sandro2/xmega-qrp/Documentation/Final_Report/Final_Report.pdf

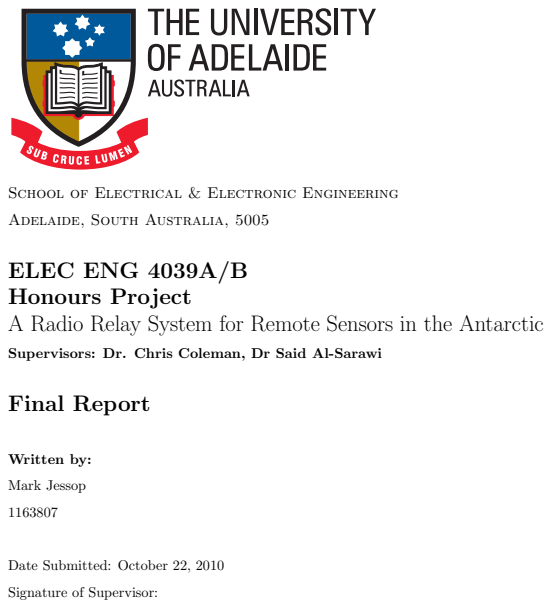
[picture p5: page 1]
Final Report; Written by:; Mark Jessop

School of Electrical & Electronic Engineering

Adelaide, South Australia, 5005

ELEC ENG 4039A/B
Honours Project
A Radio Relay System for Remote Sensors in the Antarctic

Supervisors: Dr. Chris Coleman, Dr Said Al-Sarawi

Date Submitted: October 22, 2010

Signature of Supervisor:

Abstract

A common problem with remote sensor systems is the retrieval of data. Satellite-based sys-

tems are expensive, as is travelling to the sensor. HF propagation provides an inexpensive

alternative. Radio signals below 30MHz can easily bounce off the ionosphere, travelling

thousands of kilometres using only a few watts of transmit power. Based around an At-

mel XMega Micro-Controller and using Direct Digital Synthesis techniques, this project

aims to provide a reliable low power HF telemetry system, usable in a variety of remote

telemetry applications. By making use of the XMega’s power-save modes and using high-

efficiency RF amplifiers, power consumption is minimised, allowing months of operation

from battery power.

CONTENTS | CONTENTS

# Contents

1 Introduction | 4
2 Hardware | 6
3 Software | 8
4 Testing | 8
5 Project Management | 8
6 References | 8
Appendix A XMega Dry Ice Testing | 9
Appendix B Software | 10
Appendix C Schematics & PCBs | 11

1 INTRODUCTION

# 1 Introduction

Many scientific experiments require data logging over a long time period, and in remote locations. To

further research progress, it is desirable for some of the collected data to be accessible throughout the

run of the experiment.

A number of solutions exist to obtain data from a remote sensor unit. The first is to physically access

the remote sensor station, and copy data from whatever storage may exist. For very remote sensor

units visiting the site may be impractical or too costly, so some form of wireless communication is

often used.

Satellite data transmission is a reliable way of retrieving data, but comes at a high cost. For example,

using the Iridium Satellite constellation to transmit data would cost approximately USD$2.50 per

minute, with a 2400 baud data rate[1]

The other option is to other methods of radio communication. For reasonably short (<50km) distances

VHF or UHF telemetry can be used. For example, the Australian Bureau of Meteorology uses a

network of VHF transmitters[2] and repeaters to obtain data from weather stations around Adelaide.

VHF and UHF can work for longer distances (>50km), but with less reliability. Transmission at these

distances relies on tropospheric ducting, a phenomenon that is not always present. To obtain high

reliability long distance transmission, we must move further down the electromagnetic spectrum, to

the HF (‘high frequency’) band.

### The Ionosphere

Radio waves in the HF band propagate mainly by two means: ground-wave and sky-wave. Ground-

wave, as the name suggests, travel along the surface of the earth. Ground-wave signals are attenuated

as they travel along the earth’s surface, limiting their distance. Sky-waves however, refract off a charged

region of the earth’s atmosphere called the ionosphere, and can travel extremely long distances.

The ionosphere is a complex and ever-changing layer (actually multiple layers) of ionized particles

that surrounds our planet. It consists of multiple layers , given the letters D, E and F. The D-layer,

which is the lowest and is strongest during the day, attenuates (absorbs) RF energy below a certain

frequency. The E and F layers, however, reflect RF energy below a certain critical frequency, fc.

This property enables HF radio signals to be ‘bounced’ off the ionosphere, even multiple times, to

communicate over long distances. Losses from the D-layer, and the critical frequencies of the E and F

layers determine the Lowest Usable Frequency (LUF) and Maximum Usable Frequency (MUF) for long

distance communication. Ionospheric prediction services, such as the one provided by the Australian

government[3]
, provide tools to predict these frequencies, and hence determine the optimal frequency

1 INTRODUCTION

for reliable communication.

Another consideration is the angle at which a radio wave interacts with the ionosphere. If a radio signal

is aimed at the horizon it will hit the ionosphere at a shallow angle, resulting in very long propagation

distances, possibly thousands of kilometres. For shorter distances the signal is aimed close to vertical,

allowing much shorter hops, perhaps a few hundred kilometres. This method of transmission is called

‘Near Vertical-Incidence Skywave’ (NVIS) and is the primary method this project will use to transmit

data.

### Project Applications & Aim

Design and build a low power short wave data transmitter that can translate low rate data

into a modulated short wave output with sufficient power to transmit the data over several

hundred kilometres on an Antarctic communication path. - Original Project Aim

This project was originally intended to be used by a researcher stationed in Antarctica, hence the

project name. Throughout the course of the project, lack of information from the researcher prompted

a widening of the project’s scope to include other telemetry applications. Examples include:

- Use in the Australian outback for energy research.
- Use on remote islands, for weather monitoring.
- As a telemetry system for a high-altitude weather balloon.

At it’s core, the purpose of transmitter is to read in data from a number of sources, buffer the data,

and then transmit it using some form of HF radio modulation. The exact form of HF modulation was

not defined, to allow experimentation with a number of different modes. To enable high power testing

without many licensing issues, it was decided that the project would target the 80m (3.5MHz) and

40m (7MHz) amateur radio bands. This also had the added benefit of having a large number of radio

operators available to report on signal reception.

To keep the spirit of the original application it was decided to keep the constraints which Antarctic

operation required. These were:

1. Must be able to operate at extremely cold temperatures (< −30◦C), such as those commonly

experienced in Antarctica.

2. Must be very energy efficient, to enable operation from battery power for long periods.

These constraints formed the guidelines for the design and construction of a prototype transmitter,

which was successfully tested and then flown as a payload on a high-altitude weather balloon.

2 HARDWARE

# 2 Hardware

## 2.1 CPU

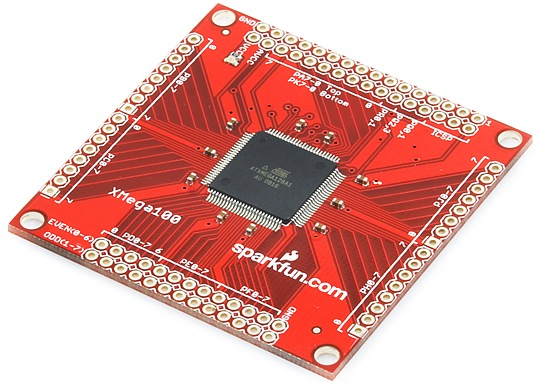
[picture p6: figure]

Figure 1: XMega100 Break-

out Board

The main CPU of the HF transmitter is an Atmel AT-XMega128A1,

an 8-bit micro-controller running at clock speeds up to 32MHz. It has

numerous peripherals, such as 12-bit ADCs, a 12-bit DAC, and many

I/O lines. A particularly interesting feature is the ability to wire SD-

RAM into three of the I/O ports and have the extra memory appear

at the end of the XMega’s memory space. This is called the ‘External

Bus Interface’ (EBI) and allows the buffering of large portions of data

with little external circuitry.

The XMega was chosen over other similar micro-controllers (such as

the MSP430) primarily due to the open-source and cross-platform

compiler tools available. Software development was primarily carried

out on an Apple Macbook, and having a compiler and programmer working without rebooting into

Microsoft Windows proved very useful.

For the purposes of easy development, two breakout boards were purchased. The first, a Sparkfun

XMega100 breakout board (Figure 1), simply gives access to the I/O pins on the IC, and was bought

as a means to evaluate the micro-controller as a viable platform. The second, an Atmel XPlain

development board, has buttons, LEDs, and a number of extra peripherals, such as 8MB of SDRAM

and 8MB of NAND-Flash memory. This board was used for most development work, as the buttons

and LEDs proved extremely useful for debugging code.


Figure 2: XPlain Development Board

When running at 32MHz with most peripherals disabled,

the XMega was measured to draw 20mA of current at 3.3V.

Running at 2MHz, the current draw was measured at 2mA.

The XMega also has a number of power-save modes, where

an ultra-low-power 32KHz oscillator is used. The data-

sheet states these modes draw between 0.1 and 3µA de-

pending on what functions are enabled, but this has not

been tested. From this information, we can see that the

XMega’s power requirements are extremely minimal, espe-

cially when running at low clock speeds.

To see if the XMega128A1 would satisfy the cold-climate

operation requirement, the Sparkfun breakout board was subjected to low temperature testing. Using

2.2 Signal Generator | 2 HARDWARE

frozen CO2 (dry-ice), the temperature of the XMega was lowered to −54◦C. The internal 32MHz

oscillator drifted upwards to 33MHz, with the XMega still continuing to function. Further details of

the test process appear in Appendix A.

## 2.2 Signal Generator


Figure 3: AD9835 Breakout

Board

The start of the transmitters RF section begins with the signal gener-

ator. Two signal generators were experimented with for this project,

the Analog Devices AD9834 and AD9835. Both devices are pro-

grammable Direct Digital Synthesis (DDS) signal generators, able

to produce sine wave output between 1Hz and 25MHz.

Inside each device is a 10-bit 50Msps DAC, clocked using an exter-

nal 50MHz oscillator. Serial Peripheral Interface (SPI) programmed

control registers allow the programming of two different frequencies.

These can be selected between using either control bits or a ded-

icated input pin, allowing FSK modulation. The registers can be

reprogrammed approximately 7500 times per second, allowing MFSK

modulation with high symbol rates. Phase registers (2 in the AD9834, 4 in the AD9835) permit BPSK

and QPSK modulation, though this was not used in the project.

The AD9834 is a lower power device, drawing 8mA at 5V, while the AD9835 can draw up to 40mA.

In practice, it was found that when the current draw of the required master oscillator was included,

the power requirements of both devices (with supporting circuitry) were very similar ( 35mA @ 5V).

The AD9835 was purchased on a breakout board from Sparkfun prior to the project, which started

the idea of using a DDS to power the RF section. The AD9834 was purchased as a bare IC, and a

breakout PCB was designed and constructed for it. Schematics and PCB designs for this board appear

in Appendix C.1. The breakout was originally designed to run at 3.3v, the same voltage level as the

micro-controller. However, because the board ended up using a 5V master oscillator (3.3v models

were not available at the time), it had to be operated entirely at 5V. Even running at 5V the AD9834

accepts 3.3v logic levels from the XMega, unlike the 5V AD9835 which requires logic level conversion.

Being a DAC-based signal generator, the output waveform is not a pure sine. Sampling theory tells

us that at 10MHz we would only 5 samples per cycle, and at 25MHz only 2 samples per cycle. At the

target frequency of 7MHz, clock feedthrough (50MHz) was measured at -20dB below the target output.

In Australia, spurious emissions should be -30dB below the fundamental frequency, so a reasonably

sharp low-pass filter was designed to drop the clock feedthrough down by about -50dB. Use of a tuned

antenna will may also attenuate the clock feedthrough enough to meet legal limits, but this could not

2.3 Pre-Amplifier

be tested easily.

## 2.3 Pre-Amplifier

## 2.4 Class E Power Amplifier

# 3 Software

## 3.1 Hardware Libraries

# 4 Testing

# 5 Project Management

# 6 References

[1] Iridium Communications Inc. “Iridium Satellite Call Plans”” http://www.iridiumphones.com.

au/Call%20Plan%20Brochure%20-%20Post-paid.pdf, (http://www.iridiumphones.com.au/Call%20Plan%20Brochure%20-%20Post-paid.pdf) 2010

[2] ACMA Register of Radio-communications Licenses, Met Bureau Site near Corkscrew Rd

Montacute http://web.acma.gov.au/pls/radcom/assignment_search.lookup?pACCESS_ID=

1320447&pDEVICE_ID=1316356 (http://web.acma.gov.au/pls/radcom/assignment_search.lookup?pACCESS_ID=1320447&pDEVICE_ID=1316356)

[3] Australian Bureau of Meteorology, “IPS Online HF Network Frequency Selection Tool” http:

//www.ips.gov.au/HF_Systems/7/1/10, 2010

# Appendices

# A XMega Dry Ice Testing

To test the AT-XMEGA128A1 breakout board, the chip was programmed to output the internal clock

signal on a I/O pin, and one of the UARTs was programmed to continually send out “Hello World” at

9600 baud. A LED was also attached to the board, and the chip programmed to flash it at 1Hz. The

breakout board assembly was wrapped in bubble wrap (for insulation) with a ribbon cable exiting

the insulation to carry the data lines. The insulated board was then placed in a small foam Eski

containing approximately 3KG of dry ice. Over the course of an hour, the chip cooled down to -49◦C,

where it stayed for approximately 20 minutes. After shuffling the dry ice slightly, the chip cooled down

a further 5◦C, to -54◦C at which point the test was aborted. Throughout the test the clock frequency

and chip temperature were measured, to produce the plot in Figure 4.

AT-Xmega128A1 32MHz RC Clock Drift vs Frequency

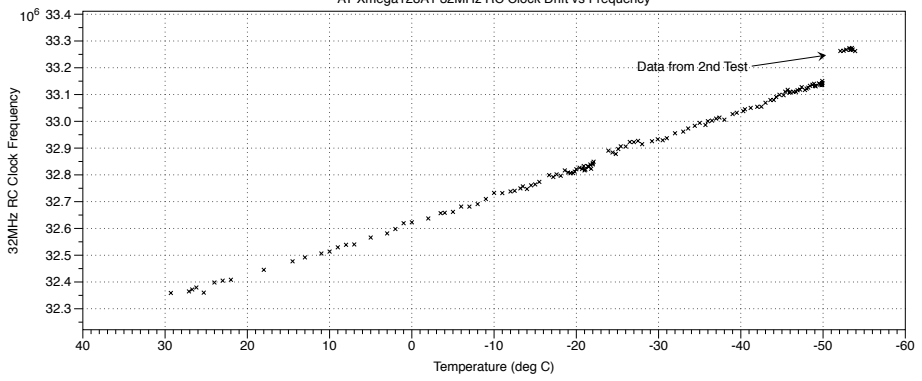
[picture p7: figure]
Data from 2nd Test; 32MHz RC Clock Frequency; Temperature (deg C)

Figure 4: AT-XMEGA128A1 RC Clock Drift

APPENDIX B SOFTWARE

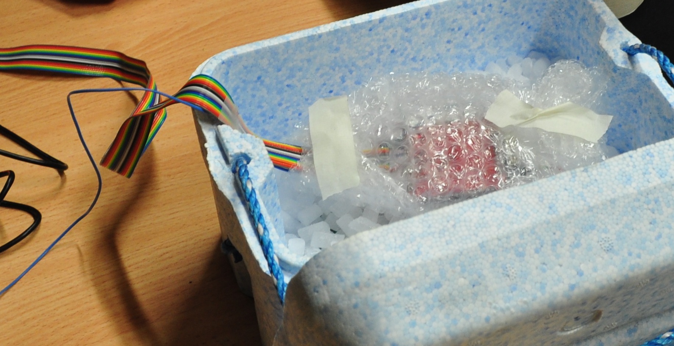
[picture p8: figure]

Figure 5: AT-XMEGA128A1 Breakout Board Wrapped in Insulation

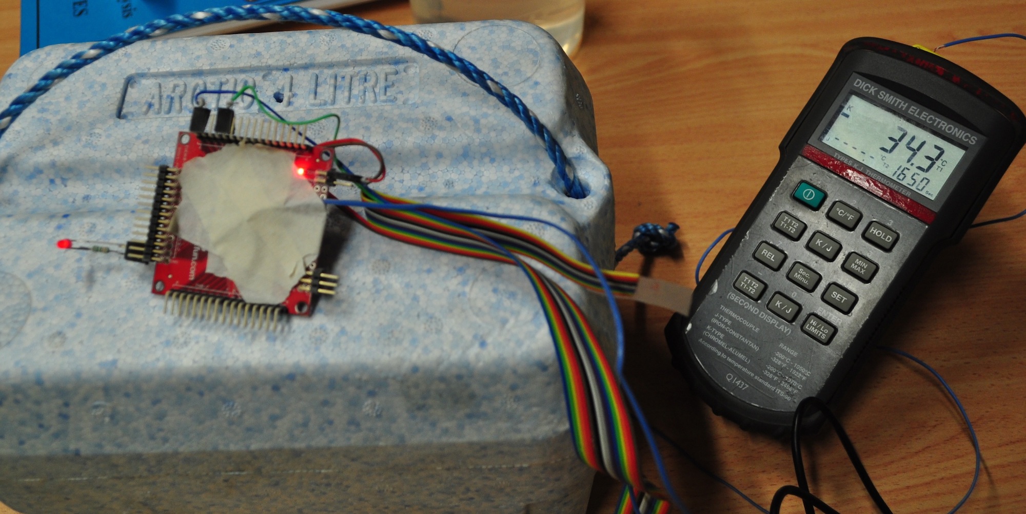
[picture p9: figure]

Figure 6: AT-XMEGA128A1 Breakout Board Warming up after testing.

# B Software

All software for this project has been released under the GPLv3 license.

## B.1 The Arduino Project and the XMega

The Arduino is an

open-source electronics prototyping platform based on flexible, easy-to-use hardware and

APPENDIX C SCHEMATICS & PCBS

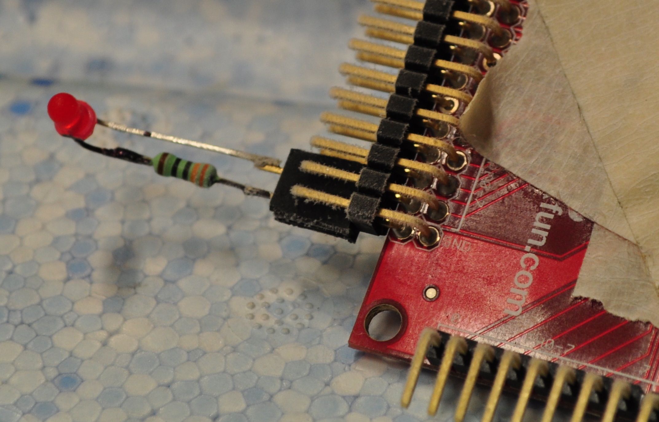
[picture p10: figure]

Figure 7: Ice forming on the XMEGA’s pin headers after testing.

software.¹

Since many users of the Arduino haven’t had much experience in programming, many libraries have

been created to fulfil various needs. It’s fairly common to begin working on a bit of code to drive

some chip, to find that someone has already written a library a few months previously. To quickly

get sections of the XMega’s codebase working, it was decided to port certain Arduino libraries to the

XMega platform.

Arduino’s IDE uses the ‘wiring’ programming language. Wiring is a ‘C-like’ language, following most

of C’s syntax, to the point that the Arduino IDE uses a collection of C++ libraries to ‘convert’ wiring

to C++ for compilation. While these libraries could be ported to the XMega allowing usage of the

Arduino IDE for this project, this would have required a lot of work and been out of scope. Instead,

the Arduino libraries which were needed (OneWire, DallasTemperature, TinyGPS) were individually

ported. This involved replacing various Arduino-specific function calls with generic AVR-C calls, and

some other minor code changes.

# C Schematics & PCBs

## C.1 AD9834 Breakout Board

1http://arduino.cc/

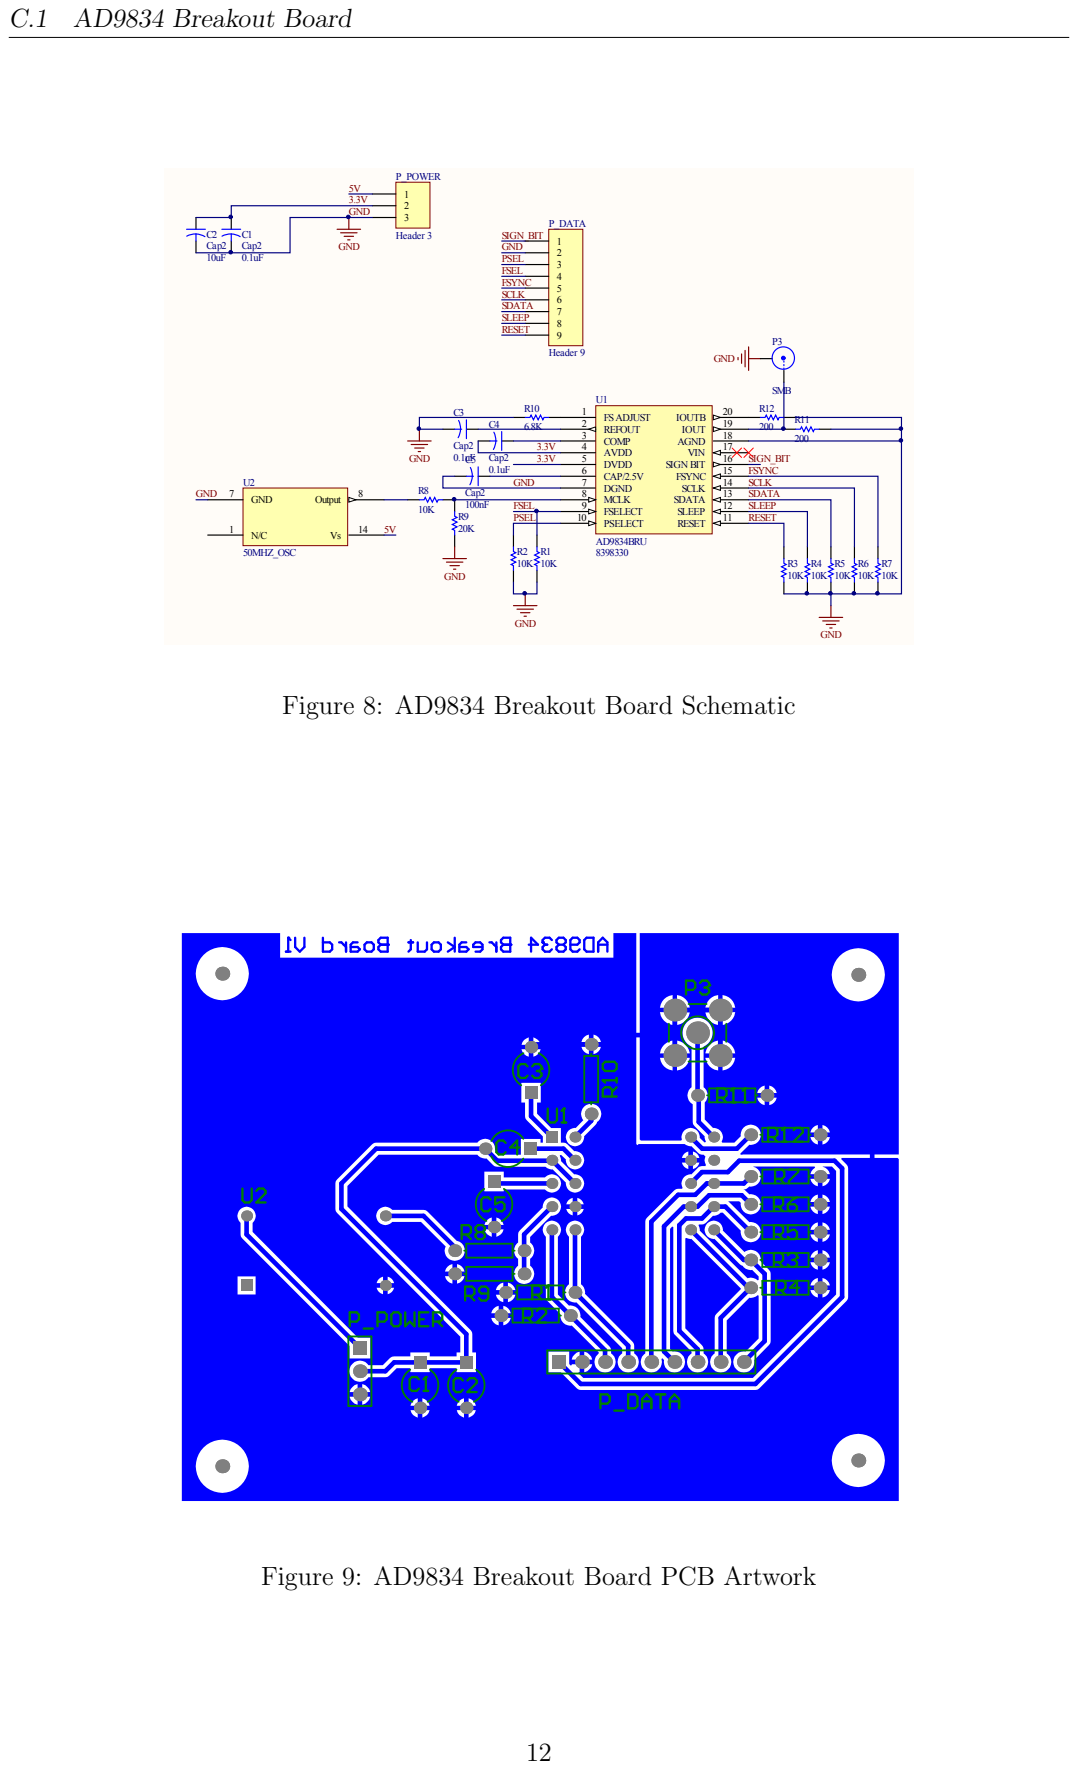
[picture p11: page 12]
C.1 AD9834 Breakout Board; A7(%LM7) ! 3NAOM) " &OPQ # (R%% $ %R%% S &(Q;"aSR = %T.% U P&VW G A7NVN&) F; Q7NVN&) !<; !! 7VNNQ; !G YOM); !F YOM)'; 7VNNQ 3N7N); 7VNNQ; =aGW; QHQO]N3

Figure 8: AD9834 Breakout Board Schematic

Figure 9: AD9834 Breakout Board PCB Artwork
