sandro2/xmega-qrp/Documentation/ProposalSeminar/Proposal_Presentation.pdf

## A Radio Relay System for Remote Sensors in the Antarctic

Proposal Seminar

Mark Jessop

March 19, 2010

Supervisor: Dr Chris Coleman | Co-Supervisor: Dr Said Al-Sarawi
Mark Jessop | A Radio Relay System for Remote Sensors in the Antarctic

## Project Background

I Research team operating ionospheric measurement equipment in Antarctica.
I Equipment left in the field for many months at a time.

I Results are obtained only when the equipment is retrieved.
I Not much can be accomplished while the equipment is in the field.

I Need some way to gain access to the data!

## Project Aim

I Design and build a low power short wave data transmitter that can translate low rate data into a modulated short wave output with sufficient power to transmit the data over several hundred kilometres on an Antarctic communication path.

## Block Overview

Sensors

Data Bus | Buffer
Data Tap

/ CPU

OO

/ RF Signal
Generator

/ Power
Amp

/Antenna

Storage

## Limitations & Challenges

I Low power budget
I Extremely cold temperatures I Ionospheric absorption loss

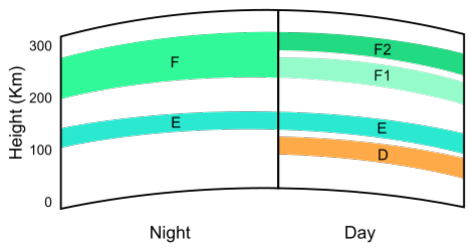
[picture p12: figure]

Figure: Layers of the Ionosphere

## Power Budget

I Equipment operates from battery power for many months at a time.
I Efficiency is extremely important.
I Components will need to be carefully selected for minimal power consumption.
I Transmission frequency may need to be lowered to keep within constraints.

## Preliminary Sizing Calculations

If we make a few assumptions, we can use the Friis transmission equation and the Shannon-Hartley Theorem to calculate the theoretical maximum bit rate of a radio link.
Assume:
I 200km Distance between TX and RX (on ground)
I 400km radio path (via near-vertical skywave)
I 5MHz Transmission frequency (λ = 60m)
I No ionospheric absorption loss (Not Realistic!) I Dipole antennas one each end (Gt = Gr = 1.5)

I 10dB SNR required
I -114dB[2] background noise at 5MHz

## Preliminary Sizing Calculations - SNR

Using 1W transmission power, we can calculate the power at the receiving antenna:

Pr =

PtGtGr
(4πR/λ)

2

=

1 × 1.5 × 1.5
(4π × 400000/60)²

= 0.3206nW = −94.94dB

SNR = 114 − 94.94 = 19.06dB = 80.54

## Preliminary Sizing Calculations - Capacity

We can use the Shannon-Hartley theorem to calculate the theoretical maximum channel capacity of the link:

C = B log2

(1 + SNR)

Where C is the channel capacity (in bits/s) and B is the signal bandwidth. Assuming Binary FSK modulation is used with a 600Hz frequency shift, we calculate the maximum channel capacity as:

C = 600 log2

(1 + 80.54) = 3809.66 bits/s

To ensure reliability, a much lower bit-rate (∼ 600 bits/s) would be used.

## Preliminary Sizing Calculations - Power Usage

To get a rough idea of the power usage, let us assume we are transmitting at 600 bit/s for one hour (263.67 kB of data).
The power usage of some devices that could be used are as follows:

I Microcontroller - 75mW in active mode [3]
I Signal Generator - 40mW when active [4]

I Power Amplifier - 1W (idealised)

So under these ideal conditions, the transmitter will draw 1.115W when transmitting, which is 4014 Joules of energy for one hour of transmission.

## Temperature

I Mean annual temperature for Antarctica’s interior is −57◦C. I Standard industry specification is −55◦C to +125◦C.

I Not all devices conform to this spec, and many will be unreliable at these limits!

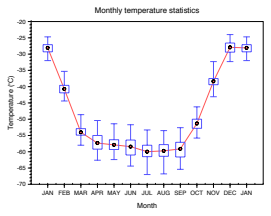
[picture p13: figure]
Month; Temperature (oC); Monthly temperature statistics

JAN FEB MAR APR MAY JUN JUL AUG SEP OCT NOV DEC JAN

Figure: Monthly Temperature Statistics for the Amundsen Scott Research Station [1]

## Budget

Maximum cost = $250
I Devices for stress testing (i.e. micro-controllers) - $50 I RF System - $50
I Control System - $50
I PCB Construction - $50

## Timeline

Task | Expected Completion
Background Research | S1 Week 3
Simulation & Component Research | S1 Week 5
High-level design | S1 Week 7
Software Design & Coding | End of S1
Hardware Design | End of S1
Data-Tap
Controller
RF System
Prototype construction | Early S2
Testing & Optimisation | Mid S2

## Deliverables

I Proposal Seminar (Now!)
I Stage 1 Design Document (S1 Week 5) I Progress report (S1 Week 11)
I Interim Performance Report (S1 Week 12) I Final Seminar (S2 Mid-semester break)
I Final Report (S2 Week 11)
I Final Performance Report (S2 Week 12) I Project Exhibition (S2 Week 12)

## Risks & Dependencies

I No life-threatening risks involved with this project.
I Minor risks involving electrical/RF safety.

I Minor risks involving hardware damage, shipping problems, etc.
I Medium-level risk involved if project leader becomes ill.

## References

[1] G. Marshall. “Monthly mean surface temperature at Amundsen-Scott station” http://www.nerc-bas.ac.uk/icd/gjma/pole.temps.html Mar. 9, 2010 [Mar. 11, 2010]
[2] S.K. Datta. “Radio Noise Measurement in HF/VHF Band at Antarctica” http://dspace.ncaor.org:8080/dspace/bitstream/123456789/707/1/115-119.pdf (Google Cache), 1995 [Mar. 15, 2010]
[3] Atmel, “ATMega168PA Electrical Characteristics”, ATMega168PA Datasheet, Dec. 2009
[4] Analog Devices, “AD9834 Specifications”, AD9834 Datasheet, Feb. 2003

## Questions & Answers

## Any Questions?
