sandro2/xmega-qrp/Documentation/Final_Seminar/final_seminar.pdf

Introduction
Hardware
Software
Example Application & Prototype

# A Radio Relay System for Remote Sensors in the Antarctic

# Final Seminar

# Mark Jessop

# October 8, 2010

Mark Jessop | A Radio Relay System for Remote Sensors in the Antarctic

Example Application & Prototype

Motivation
Hardware & Software Overview

# Motivation

# Aim - Design and build a low power HF data transmitter for use in

an antarctic remote sensor application.

I Project scope expanded mid-year to include other applications. I Initial Constraints still used.

## I Low Temperature Operation I Low Power Consumption

# I Can be used in a huge amount of applications!

Example Application & Prototype

Motivation
Hardware & Software Overview

# Hardware & Software Overview

# I Modular Design & Construction

# Hardware & Software Overview

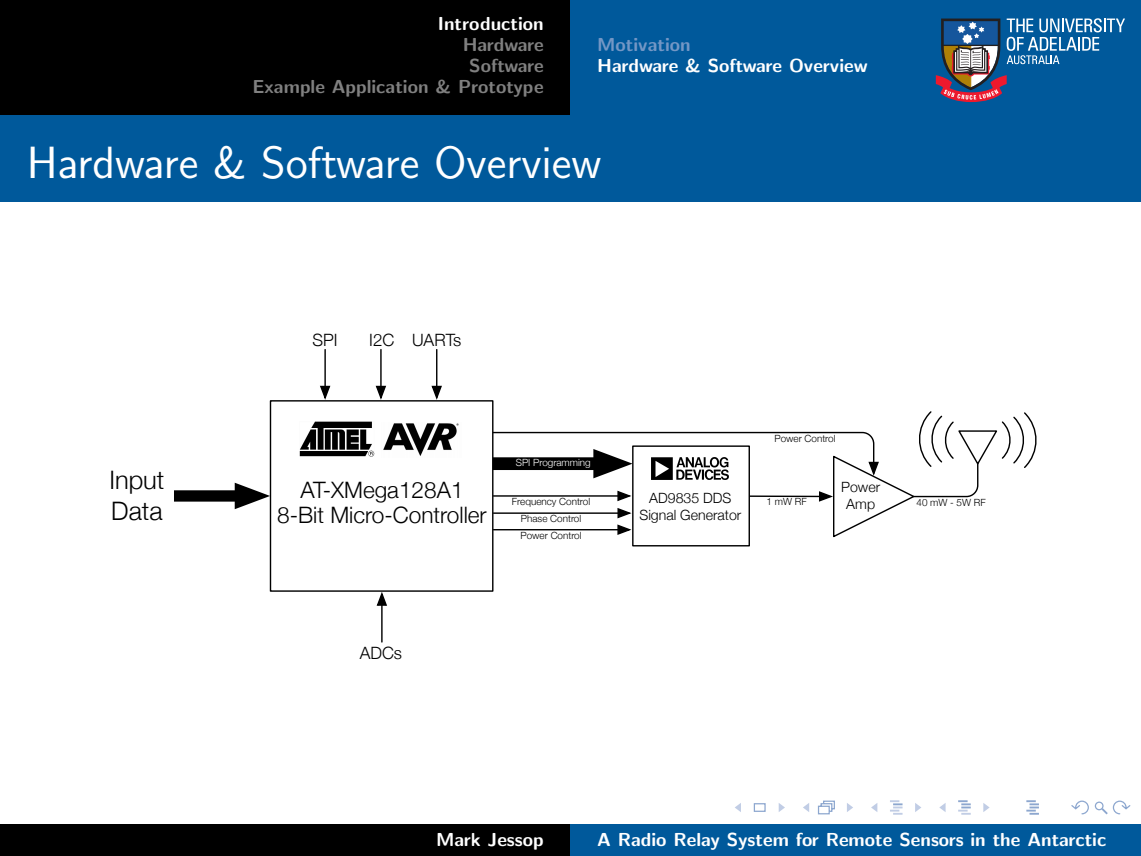
[picture p19: page 4]
AD9835 DDS Signal Generator; SPI Programming; Frequency Control; Phase Control Power Control; Power Control; Power Amp; SPI; I2C UARTs; ADCs; Input; Data

Motivation
Hardware & Software Overview

Example Application & Prototype

AT-XMega128A1
8-Bit Micro-Controller

Example Application & Prototype

CPU
Signal Generator
Power Amplifier
Power Supply
Hardware Testing

# CPU - Atmel ATXmega128A1


# Atmel XPlain Development Board I Atmel ATXmega128A1 Micro-Controller, clocked at 32MHz I 8MB SDRAM

# I 8MB NAND Flash Memory

I Low Power Consumption - 18mA @ 32MHz, 1.4mA @ 2MHz,

# 1.16µA Power-Save

Example Application & Prototype

CPU
Signal Generator
Power Amplifier
Power Supply
Hardware Testing

# Signal Generator - Analog Devices AD9835

# I Original intention was to use an AD9834

# I AD9835 Board ended up having the same power requirements!


# Analog Devices AD9835

I Can generate Sine-waves between 1Hz - 25MHz. I 2 programmable (via SPI) frequency registers.
I Dedicated pins for switching between registers.
I Using 16MHz SPI clock, can reprogram at 7500Hz.

Example Application & Prototype

CPU
Signal Generator
Power Amplifier
Power Supply
Hardware Testing

# Power Amplifier

I Op-Amp based pre-amplifier - 40mW output.

I Class C NPN Transistor Amplifier - 1W output. I Class E MOSFET Power Amplifier - 5W output.

Example Application & Prototype

CPU
Signal Generator
Power Amplifier
Power Supply
Hardware Testing

# Power Supply

# Supply Requirements

I 12v, 5v and 3.3v rails are required.
I Linear Regulators are very in-efficient. I Switch-mode Regulators used instead.

# Battery Power

I Powered from a 12V SLA for testing.

I For sub-zero use, Lithium-iron primary cells can be used.

# I Lithium-thionyl chloride secondary cells can operate down to

−60◦C.

Example Application & Prototype

CPU
Signal Generator
Power Amplifier
Power Supply
Hardware Testing

# Low Temperature Testing

I All major components rated to either −40◦C or −55◦C.

# I Doesn’t hurt to check!

I Dry Ice used to cool components below rated limits.

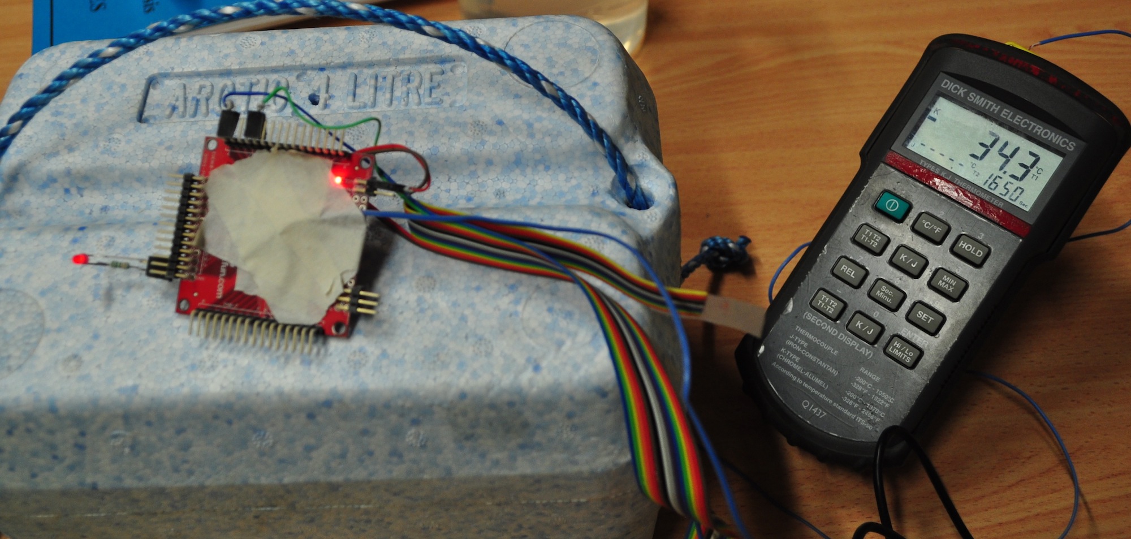
[picture p20: figure]

Example Application & Prototype

CPU
Signal Generator
Power Amplifier
Power Supply
Hardware Testing

# Low Temperature Testing

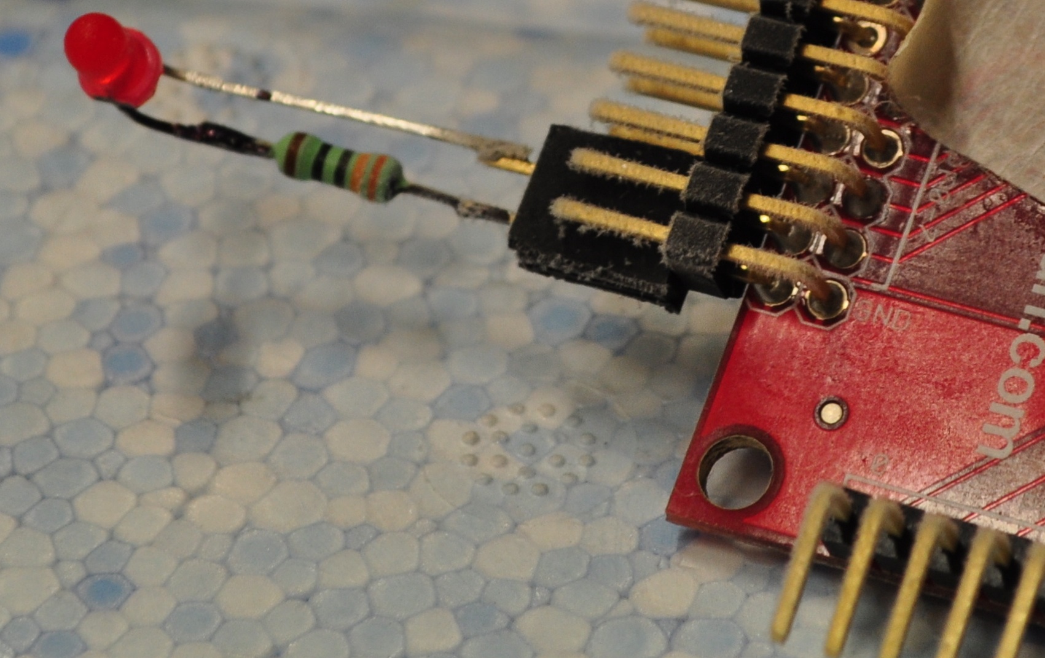
[picture p21: figure]

# I AT-XMega’s internal RC 32MHz oscillator drifts up to 33MHz

at −55◦C.

# I AD9835’s output only drifts up by ∼300Hz at −40◦C!

Example Application & Prototype

Overview
Morse
RTTY
DominoEX
Testing Procedures

# Software Overview

I Coded in C and C++.
I Libraries built first, more complex applications later.

# I Morse, RTTY (FSK) and DominoEX modulation

implemented.
I Data acquisition from onboard ADCs, UARTs, or I²C Devices.

Example Application & Prototype

Overview
Morse
RTTY
DominoEX
Testing Procedures

# Morse Code & QRSS

# I Morse Code at very slow speeds can be received over very

long distances.
I Signals are pulled out of the noise floor with DSP techniques. I Very low signal bandwidth.
I Not very useful for transmitting lots of data.
I Good for beaconing.

Figure: QRSS Morse Broadcast, signal level -23dB below the noise floor.

Example Application & Prototype

Overview
Morse
RTTY
DominoEX
Testing Procedures

# RTTY (FSK)

I FSK Modulation, with start and stop bits.

# I Implemented to operate between 50 and 300 baud

(symbols/sec).

I Carrier Shift programmable from 170 to 425Hz.

# I Plenty of existing software to decode RTTY (i.e. fldigi)

## Figure: 300 Baud RTTY, with 425Hz Carrier Shift

Example Application & Prototype

Overview
Morse
RTTY
DominoEX
Testing Procedures

# DominoEX (MFSK)

# I The first MFSK-based mode implemented - utilises

Incremental Frequency Shift Keying.
I Resistant to multi-path and doppler effects.

# I 6 variations available, each with different symbol rates (3.9 to

29.5Hz) and bandwidths (173 to 524Hz).

I Data rates varying from 2 to 14 characters per second.

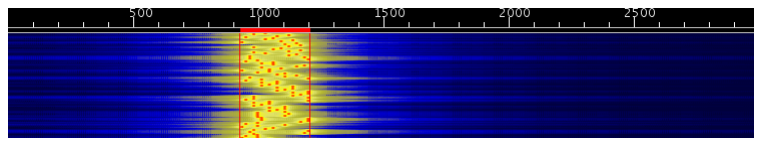
[picture p22: figure]

## Figure: DominoEX8 - 7.8125 baud, 346Hz Bandwidth

Example Application & Prototype

Overview
Morse
RTTY
DominoEX
Testing Procedures

# Testing Procedures

I Checking of library operation once coded.

Example Application & Prototype

# Example Application - HAB Telemetry Transmitter

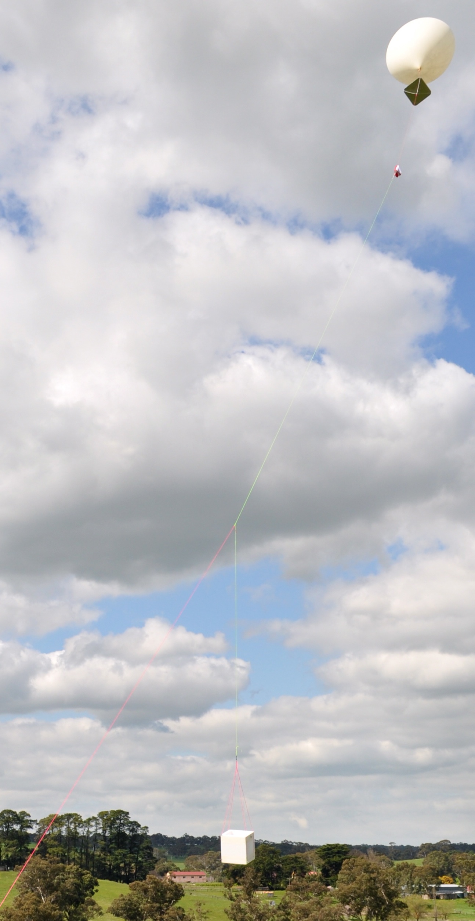
[picture p23: figure]

# Amateur High Altitude Ballooning (HAB)

# I Aims to set height / distance records

for balloon flights.

# I Some form of telemetry system used

to track balloon in flight.

# I 433MHz Single-Sideband

Transmissions commonly used.

Example Application & Prototype

# Example Application - HAB Telemetry Transmitter

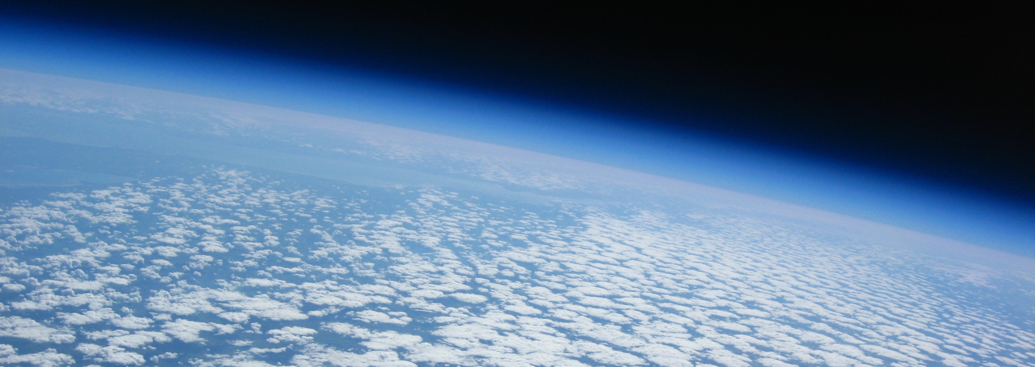
[picture p24: figure]

# I Local Amateur HAB group - Project Horus I Have offered to fly a prototype transmitter, with

modifications.

## I GPS Receiver, for positioning information I Temperature Sensors

Example Application & Prototype

# Prototype

# I System ‘Motherboard’

## I XMega I AD9835 DDS VFO I UBlox5 GPS Module

I I

## 2C Temperature Sensors

# I Amplifier Module

Example Application & Prototype

# References

Saft Lithium-thionyl chloride (Li-SOCl2) Cell Range http://www.saftbatteries.com/Produit_LSH_cell_range_303_8/Default.aspx
