sandro2/xmega-qrp/Hardware/LPF AC Analysis.csv

Hz | dB(vout/vin)
100000 | -16.9003944396973
100230.5234375 | -16.9003868103027
100461.578125 | -16.9003810882568
100693.1640625 | -16.9003734588623
100925.2890625 | -16.9003658294678
101157.9453125 | -16.9003582000732
101391.140625 | -16.9003505706787
101624.8671875 | -16.9003429412842
101859.140625 | -16.9003353118896
102093.9453125 | -16.9003276824951
102329.296875 | -16.9003200531006
102565.1953125 | -16.9003124237061
102801.6328125 | -16.9003067016602
103038.609375 | -16.9002990722656
103276.140625 | -16.9002914428711
103514.21875 | -16.9002819061279
103752.84375 | -16.9002742767334
103992.015625 | -16.9002685546875
104231.7421875 | -16.9002590179443
104472.0234375 | -16.9002513885498
104712.8515625 | -16.9002437591553
104954.2421875 | -16.9002361297607
105196.1875 | -16.9002285003662
105438.6875 | -16.9002208709717
105681.75 | -16.9002113342285
105925.375 | -16.900203704834
106169.5546875 | -16.9001960754395
106414.3046875 | -16.9001884460449
106659.609375 | -16.9001789093018
106905.484375 | -16.9001712799072
107151.9296875 | -16.9001617431641
107398.9375 | -16.9001541137695
107646.5234375 | -16.900146484375
107894.671875 | -16.9001369476318
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
