sandro2/xmega-qrp/Documentation/ProposalSeminar/images/atmega8.jpg

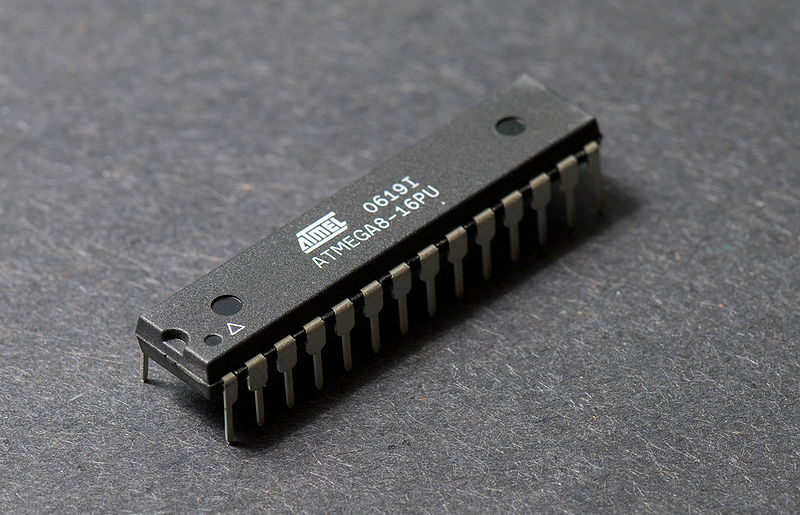
Documentation/ProposalSeminar/images/atmega8.jpg
