sandro2/xmega-qrp/Hardware/LPF Analysis.png

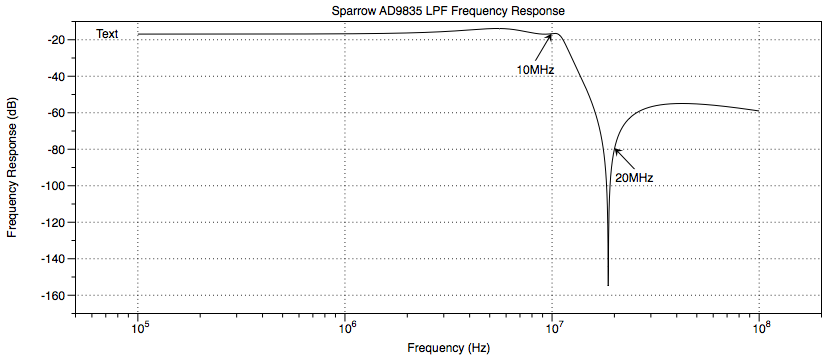
Hardware/LPF Analysis.png
