sandro2/xmega-qrp/Documentation/DesignDocument/risks.pdf

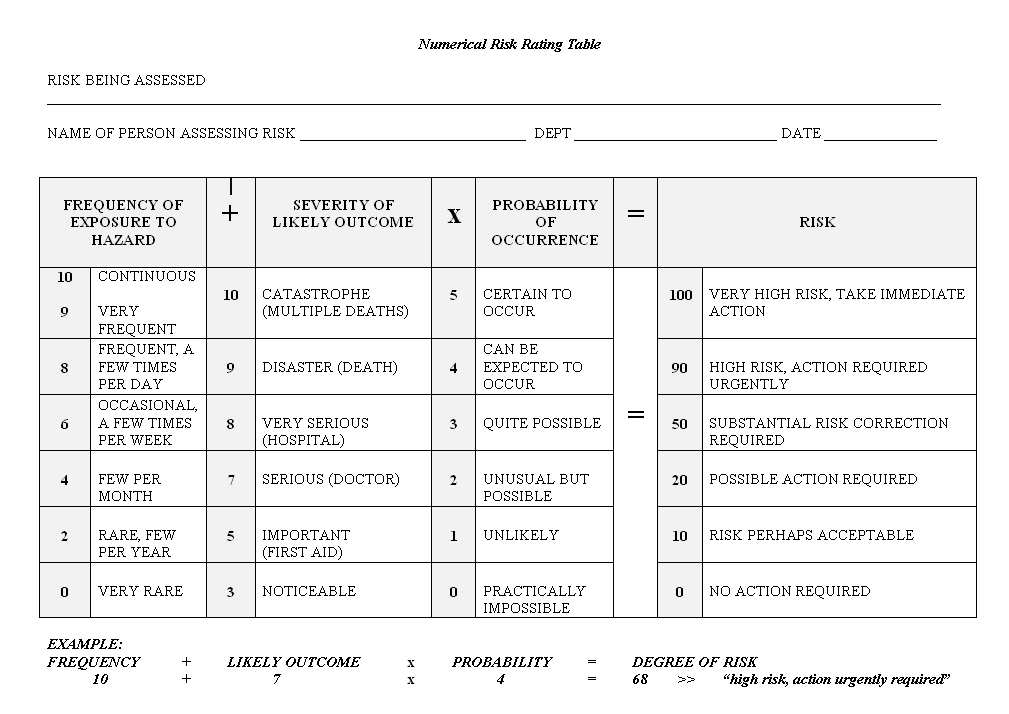
[picture p27: page 1]
