sandro2/xmega-qrp/Documentation/ProposalSeminar/images/amundsen-scott_temp_stats.pdf

## Monthly temperature statistics

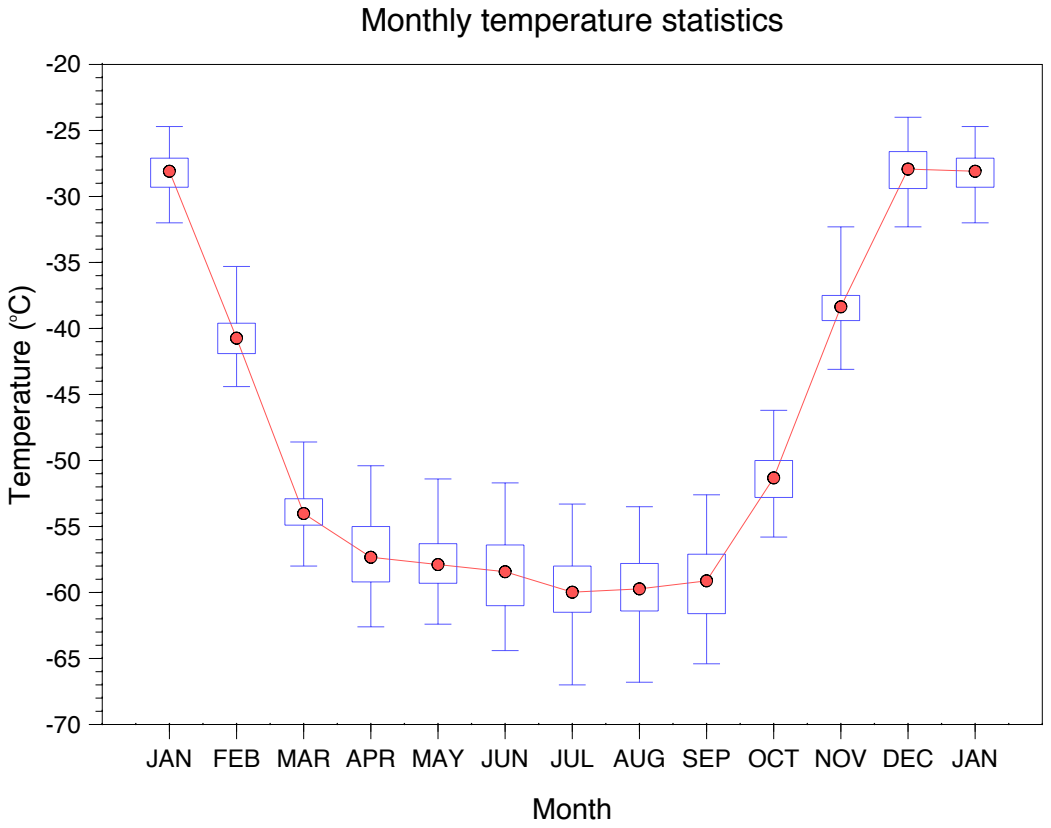
[picture p28: page 1]
Month; Temperature (oC)

JAN FEB MAR APR MAY JUN JUL AUG SEP OCT NOV DEC JAN
