sandro2/xmega-qrp/Documentation/Interim_Progress/32MHz RC.pdf

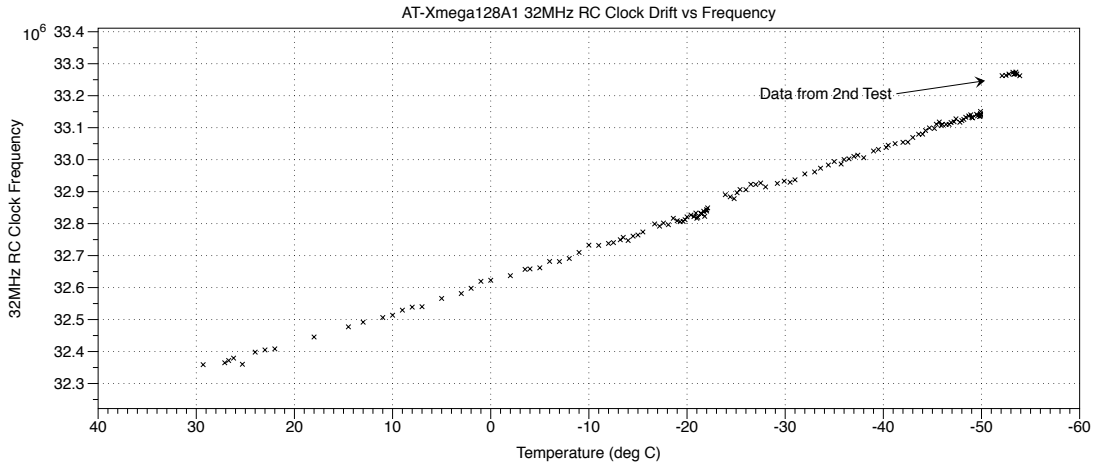
[picture p29: page 1]
Temperature (deg C)

AT-Xmega128A1 32MHz RC Clock Drift vs Frequency

Data from 2nd Test

32MHz RC Clock Frequency
