sandro2/xmega-qrp/Documentation/Final_Report/UofAlogo.pdf

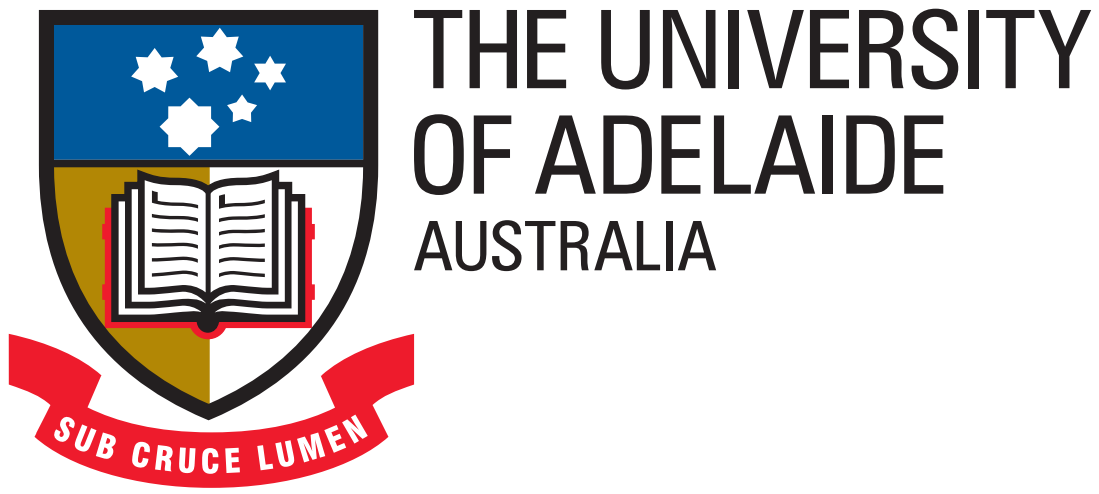
[picture p30: page 1]
