sandro2/xmega-qrp/(list of files, drawings)

Other design files:
Hardware/MainBoard.PcbDoc
Hardware/MainBoard.SchDoc
Hardware/MainBoard_AD9835.SchDoc
Hardware/MainBoard_Lib.PcbLib
Hardware/MainBoard_Lib.SchLib
Hardware/MainBoard_MKII.PcbDoc
Hardware/MainBoard_PSU.SchDoc
Hardware/MainBoard_XMega.SchDoc
Hardware/Xmega_QRP_Mainboard.PrjPcb
