sandro2/xmega-qrp/(commit log)

2010-09-08 RTTY now uses interrupts for timing
2010-09-15 utilizes xplain buttons
2010-09-29 Added mode changing on low battery'
2010-10-01 Added beginnings of mainboard design
    [LPF AC Analysis.csv, MainBoard.SchDoc, MainBoard_Lib.SchLib, MainBoard_PSU.SchDoc, MainBoard_XMega.SchDoc, Xmega_QRP_Mainboard.PrjPcb]
2010-10-01 added some ports to the schemtic
    [MainBoard_PSU.SchDoc, MainBoard_XMega.SchDoc, Xmega_QRP_Mainboard.PrjPcb]
2010-10-02 Updated mainboard schematic and started pcb design
    [MainBoard_XMega.SchDoc, Xmega_QRP_Mainboard.PrjPcb]
2010-10-02 Forgot to add PCB file
    [MainBoard.PcbDoc]
2010-10-02 Added some parts, did a lot more work.
    [MainBoard.PcbDoc, MainBoard_Lib.PcbLib, MainBoard_Lib.SchLib, MainBoard_PSU.SchDoc, MainBoard_XMega.SchDoc, Xmega_QRP_Mainboard.PrjPcb]
2010-10-02 Added AD9835 Schematic
    [MainBoard.PcbDoc, MainBoard_AD9835.SchDoc, MainBoard_PSU.SchDoc, MainBoard_XMega.SchDoc]
2010-10-02 Added supplier links for MOSFET Drivers.
    [MainBoard_PSU.SchDoc]
2010-10-04 Added DIP switches to board, not on PCB yet
    [MainBoard.PcbDoc, MainBoard_XMega.SchDoc]
2010-10-04 Temp sensor library works
2010-10-04 Added framework of final report
2010-10-05 Added mainboard MKII
    [MainBoard.PcbDoc, MainBoard_MKII.PcbDoc]
2010-10-13 Updated AD9835 schematic to include single chip level converter.
    [MainBoard_AD9835.SchDoc]
2010-10-13 Added supplier links for some components
    [MainBoard_PSU.SchDoc, Xmega_QRP_Mainboard.PrjPcb]
